HIIACODER/Starforge-Dev-Board/assets/image.png

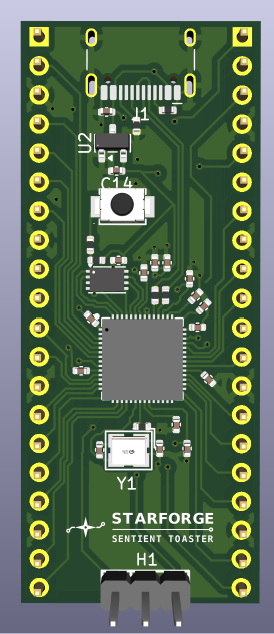
assets/image.png
