HIIACODER/Starforge-Dev-Board/assets/image-1.png

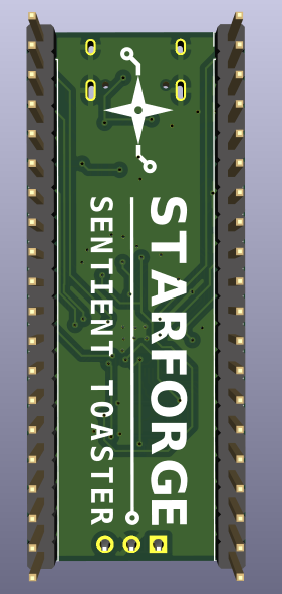
assets/image-1.png
