HIIACODER/Starforge-Dev-Board/assets/image-2.png

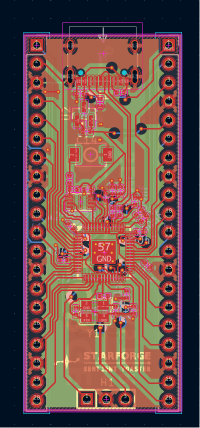
assets/image-2.png
