HIIACODER/Starforge-Dev-Board/assets/image-4.png

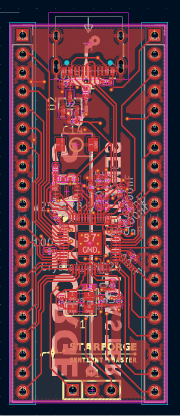
assets/image-4.png
