HIIACODER/Starforge-Dev-Board/assets/image-5.png

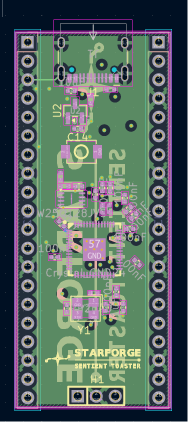
assets/image-5.png
