HIIACODER/Starforge-Dev-Board/assets/image-7.png

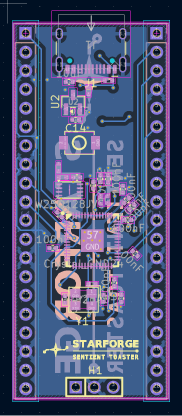
assets/image-7.png
