HIIACODER/Starforge-Dev-Board/BOM.csv

Comment | Designator | Footprint | JLCPCB Part #（optional）
1uF | C1,C10 | C_0402_1005Metric | C29266
100nF | C2,C3,C4,C5,C6,C7,C8,C9,C11,C12,C17 | C_0402_1005Metric | C1525
10uF | C13,C14 | C_0402_1005Metric | C15525
33pF | C15,C16 | C_0402_1005Metric | C107005
Header-Male-2.54_1x3 | H1 | C2937625_HDR-TH_3P-P2_54-V-M_PZ254V-11-03P | C2937625
HC-TYPE-C-16P-01A | J1 | USB_C_Receptacle_HCTL_HC-TYPE-C-16P-01A | C2894897
Header-Male-2.54_1x20 | J2,J3 | PinHeader_1x20_P2.54mm_Vertical | C50981
5.1K | R1,R2 | R_0402 | C25905
10K | R3 | R_0402 | C25744
1K | R4,R7 | R_0402 | C11702
27R | R5,R6 | R_0402 | C2909343
TS-1088-AR02016 | SW1 | C720477_SW-SMD_L3_9-W3_0-P4_45 | C720477
RP2040 | U1 | C2040_LQFN-56_L7_0-W7_0-P0_4-EP | C2040
MCP1700T-3302E/TT | U2 | SOT-23 | C39051
P25Q16SH-UXH-IR | U3 | lcsc_footprints:C7466821_USON8_L3_0-W2_0-W2_0-P0_50-BL-EP | C7466821
Crystal_GND24 | Y1 | C9002_CRYSTAL-SMD_4P-L3_2-W2_5-BL | C9002
