HIIACODER/Starforge-Dev-Board/(commit log)

2026-10-22 Finished Schematic:
    [PCB.kicad_pcb, PCB.kicad_sch]
2026-10-23 Almost Done with PCB
    [PCB.kicad_pcb, PCB.kicad_sch]
2026-10-24 Done with PCB, working on Silkscreen
    [PCB.kicad_pcb]
2026-10-24 Silkscreen done, minor edits complete, PCB COMPLETE!
    [PCB.kicad_pcb]
2026-10-24 Readme update
    [PCB.kicad_pcb]
2026-10-24 Update BOM section with CSV file availability
2026-10-24 Readme update, and added BOM.csv
    [BOM.csv, PCB.csv]
2026-10-24 Added BOM.csv
2026-10-24 Slight changes to Gerber settings for production.
    [PCB.kicad_pcb]
2026-10-24 Slight changes to Gerber settings for production, and updating CSV + placement files
    [BOM.csv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]
2026-10-24 Cleaning up production Data, and replacing flash memory to prepare for production. Ready for production.
    [BOM.csv, PCB.csv, PCB.kicad_pcb, PCB.kicad_sch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]
2026-10-26 finishing up project with BOM and FAB complete and clean.
    [PCB.kicad_pcb, PCB.kicad_sch, designators.csv, positions.csv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]
2026-11-01 Update README with BOM and component details
    Added detailed BOM for components used in the project.
2026-11-01 Enhance README with project goals and instructions
    Added additional details about the project goals, PCB design, layer stackup, and flashing instructions.
2026-11-01 Add general PCB design images section
    Added a section for general PCB design images to the README.
2026-11-11 added LED for signaling
    [PCB.kicad_pcb, PCB.kicad_sch]
2026-11-11 Enhance README with LED info and BOM pricing
    Added a red signal LED and updated BOM with unit prices.
2026-11-11 Update README with pricing details
    Added pricing information for PCB and PCBA along with shipping costs.
